SoloPenguin/Fytotron/Fytotron-Šimon-Hartmann 3.odt

Vyšší odborná škola a Střední průmyslová škola elektrotechnická Olomouc,

Božetěchova 3

PRAKTICKÁ ZKOUŠKA Z ODBORNÝCH PŘEDMĚTŮ

Fytotron
-

Vnitřní mini zahrádka pro pěstování bylinek

2018 Šimon Hartmann

Prohlašuji, že jsem praktickou zkoušku z odborných předmětů vypracoval samostatně a všechny prameny jsem uvedl v seznamu použité literatury.

……………………………

jméno a příjmení studenta

Chtěl bych vyslovit poděkování panu Marku Nožkovi za odborné konzultace a poskytnuté informace.

……………………………

jméno a příjmení studenta

Prohlašuji, že nemám námitek proti půjčování nebo zveřejňování mé práce nebo její části se souhlasem školy.

……………………………

jméno a příjmení studenta

1. Teoretický úvod
  1. – Fytotron

Fytotron(z řečtiny fyto - rostlina, tron- složité zařízení) v překladu "Klimatická komora" je zařízení k pěstování rostlin za kontrolovaných a programově regulovatelný vnějších podmínek ,zejména tedy teploty, vlhkosti a světla. Používá se ke studování působení vnějších vlivů na růst rostlin. Jedná se o produkt dvou vědeckých odvětví a to botaniky a fyziologie rostlin. **dopsat

První fytotron byl postaven pod vedením Fritsa Warmolta Wenta, nizozemského biologa, v Technologickém institutu v Kalifornii ( Caltech ) v roce 1949. F. W. Went ( 18. Května 1903 - 1. Května 1990 ) studoval na Univerzitě v Utrechtu. Jako disertační práci si vybral působení hormonu Auxin na rostliny a v roce 1928 demonstroval jeho přítomnost v rostlinách. Od roku 1927 do roku 1933 pracoval jako pracoval Went jako rostlinný patolog ve výzkumných laboratořích Královské botanické zahrady v Buitenzorg, Holandské východní Indie. Poté přijal místo na Caltech v Pasadeně v Kalifornii ,kde jako první studoval hormony v rostlinách. Sehrál důležitou roli při vývoji syntetických rostlinných hormonů, které se pak staly základem pro většinu zemědělského chemického průmyslu.

Fytotrony se v současnosti používají stále častěji. Novinkou je „Vertikální pěstování“. Místo pěstování rostlin na rozlehlých polích, které zabýrají mnoho místa, jsou rostliny pěstovány v policích, které se skládaji jedna na druhou. Tímto stylem je možné vypěstovat velké monžství rostlin na docela malém prostoru. Tato metoda se dá přirovnat ke stavění výškových domů. Díky stále více se rozmáhající technologii LED světel je výstavba takovýchto zařízení výrazně levnější, než tomu bylo v minulích letech. V minulosti se používaly sodíkové výbojky, které produkovaly celospektrální záření. Bylo to ovšem mnohlem více energeticky náročné, produkovaly velké množství tepla a výroba značně prodražovala celkovou cenu. Také se ukázalo, že používání světel , které produkují celé spektrum je zbytečné. Rostliny jsou totiž citlivé hlavně na červené a modré spektrum. A proto s nástupem LED bylo možné zaměřit se hlavně na spektum, které rostliny doopravdy potčebují. LED světla spotřebovávaji mnohem méně energie, neprodukují tolik tepla a jejich výroba v je porvonání s výbojkami, vcelku levná. Proto se v dnešní době používají stále víc a jejich upatnění stále roste. V současnosti existují dvě největší firmy, které využívají vertikální pěstování v kombinaci s LED osvětlením a to Growing Underground a AeroFarms. První, Growing Underground je anglická firma, která sídlí v Londíně ve starém bombovém kritu. Druhou je AeroFarms americká firma, sídlící v New Yorku. Ta používá velké skladištní budovy, ve kterých jsou rostliny naskládane v policích vysokých až 11m. Pečlivě také kontorlují a upravují vněší podmínky, výživu a osvětlení. Vertiklání pěstovaní je ovšem stále v dnešní době dražší než konvenční pěstování plodin na poli, levné sluneční světlo zatím stále vítězí nad umělými zdroji světla, ale s postupním nárůstém tohoto trendu je možné očekávát že za pár let by vertikální pěstování mohlo zcela osamostatnit větším města od dovozu čerstvích plodin z venkova. Douležitou věcí, kterou je třeba vspomenout je také fakt, že vertikální pěstování spotřebovává o 70% méně vody než klasické pěstování a se správnou technologií je možné tuto spořebu ještě zredukovat.

  2. – Arduino

V informatice jde o název pro malý jednodeskový počítač s mikrokontrolery ATmega od firmy Atmel. Je navrženo tak aby práce s ním byla jednoduchá a snaží se podpořit výuku informatiky na školách, tím že si na něm studenti mohou vyzkoušet, jak pomocí počítače řídit některá zařízení ( mrazák, mikrovlnná trouba, fytotron, atd. ). Arduino není navrženo jako běžný stolní počítač na rozdíl od Raspberry Pi, takže se k němu nedá jednoduše připojit klávesnice nebo monitor, ale je připraveno pro připojení LED diod, displeje z tekutých krystalu, senzorů nebo servomotorů.

Projekt Arduino vznikl v roce 2005 v Itálii ve městě Ivrea. Zakladateli byli Massimo Banzi a David Cuartielles, kteří svůj projekt pojmenovali podle Arduina Iverského, historicky významné postavy města.Cílem bylo vytvořit jednoduchou prototypovací platformu pro studenty, která umožní rychlý vývoj a jednoduché používání. Projekt zaznamenal velký úspěch. Začali vznikat nové verze a do únoru 2010 se prodalo více jak 120 tisíc kusů. Projekt Arduino získal ocenění v kategorii digitálních komunit na Prix Ars Electronica 2006.

Pro svoje potřeby jsem si vybral Arduino Mega2560, které ma 54 digitálních I/0 pinů, 16 analogových I/0 pinů a rozměry 101.6mm x 53.3mm. K Arduinu jsem připojil LCD Keypad Shield s 6 tlačítky, který zajistí vizualizaci některých výstupních dat. LCD Keypad Shield je vcelku rozměrný a na Arduinu Mega si zabral více jak polovinu pinů. Jako další jsem připojil RTC modul, který zajišťuje reálný čas, senzor teploty a vlhkosti DHT 11 a relé, které slouží k zapínání a vypínání LED pásků. Celý systém je napájený 12V DC zdrojem z počítače.

  3. – Programování

Pro programování Arduina je vyvinuto jednoduché programovací prostředí, ve kterém zvládnou naprogramovat jednoduché programy i úplní nováčci, Arduino IDE(integrated development enviroment = integrované vývojové prostředí) . Arduino je otevřená open-source,multiplatforma a na internetu lze jednoduše najít zdrojové kódy od uživatelů. Programy jsou psané v jazyce Writing, který navazuje na jazyk C.

Jazyk Writing má dvě hlavní funkce:

- Setup() - Funkce, která se zavolá při každém spuštěním nebo při stisknutí tlačítka Restart

- Slouží k nastavení pinů, proměnný, knihoven, atd.

- Loop() - Funkce, která se opakuje stále dokola

- Umožňuje tak reagovat na různé proměnlivé podněty

- Zapisuje se do něj většina logického kódu

Jak funkce Setup() tak funkce Loop() musí být zakončena složenými závorkami { }.

2. Návrh
  1. – Výpočty

Vztah člověka a rostliny ke světlu je už na samém počátku jejich existence výrazně odlišný. Pro člověka je světlo spíše psychologickým činitelem, kdy teplota světla, jeho intenzita, dynamika ovlivňují jeho bdělost, nálady a pracovní výkon . U rostlin je přítomnost světla a jeho kvalita mnohem zásadnější a má přímou souvislost s jejich fyzickým životem a kvalitním růstem. Zaměříme-li se na proces fotosyntézy (z řeckých slov fótos – světlo a synthesis – sjednocení, skládání), dospějeme k závěru, že světlo hraje v životě rostliny jednu ze zásadních podmínek.

6CO2 + 12H2O + světlo => C6H12O6 + 6O2 + 6H2O

Jelikož proces fotosyntézy probíhá ve dvou fázích je stejně jako dostatek světla důležitá i část temná. V první fázi, kdy na rostlinu dopadá světlo, dochází ke štěpení molekul vody

12H2O + světlo => 12H2 + 6O2

za vzniku vzdušného kyslíku a molekul vodíku, jenž je následně v temné fázi zužitkován na stavbu jednoduchého cukru, tedy glukózy, uložené ve vnitřní struktuře rostliny. Chemická rovnice fotosyntézy v temné fázi potom přejde do tvaru

6CO2 + 12H2 => C6H12O6 + 6H2O

Ke správnému vývoji potřebují rostliny nejen dostatek světla, ale hlavně to správné světelné spektrum. Při indoor pěstování se používají různé druhy výbojek a světelných zdrojů, které vyzařují odlišné množství světla, zasahující do několika částí světelného spektra. Světelné spektrum obsahuje tzv. spektrální barvy, které odpovídají různým intervalům (vzdálenostem) vlnových délek.

Lidské oko je schopné vnímat vlnové délky ve vzdálenosti cca od 400 do 800 nm (nanometrů), přičemž nejlépe vnímá v rozsahu 500-650 nm. Pro rostliny je důležité tzv. fotosynteticky aktivní záření (FAR), které se pohybuje v rozmezí 400-700 nm. Rostliny vnímají intenzivněji právě ve vlnových délkách, na které je lidské oko málo citlivé.

Fotosynteticky aktivní záření/radiace FAR (anglicky PAR – Photosynthetically Active Radiation) – světlo, které rostliny využívají k fotosyntéze. Zjednodušeně řečeno je to světlo, které rostliny vidí. Pohybuje se ve vlnových délkách 400-700 nm.

Ve svém projektu jsem použil tři druhy světelných zdrojů k osvětlení boxu o velikosti 0,25m x 0,35m x 0,35m. Velikost plochy, kterou osvětluji je 0,12 m².

Zdroje světla jsou žlutý, červený a modrý LED pásek. Žlutý pásek o délce 1m se světelným tokem 2100 lm, příkonem 20 W a tepelnou chromatičností 4000 – 4500 K. Červený pásek o délce 0,3m se světelným tokem 120 lm, příkonem 2W a vlnovou délkou 630 nm. Modrý pásek o délce 0,6m se světelným tokem 240 lm/m, příkonem 4W a vlnovou délkou 470 nm. Pásky jsou zapojeny sériově v třech samostatných obvodech, jejich proud je 1,6A , 0,33A a 0,17A a jejich celkový odběr je tedy 2,1A.

I = I1 + I2 + I3

Ovládání jednotlivých obvodů je zajištěno třemi relé, jež ovládá jednotka Arduino. Samo Arduino je napájeno ze stejného zdroje jako LED pásky, jeho odběr je ale zanedbatelný (0,04A), proto ho ve výpočtech nezahrnuji.

Červený LED pásek o vlnové délce 630 nm vytváří v boxu červené spektrum,které působí na chloprophyl a. Ten přispívá k tvorbě kořenového systému, dozrávání a růstu do výšky. Ve mém boxu tvoří pouze 1/6 z celkového osvětlení.

Morý LED pásek o vlnové délce 470 nm vytváří v boxu modré spektrum,které působí na chloprophyl b. Ten zajištuje tvorbu listů a cekové zelené masy. Modré LED pásky tovří 1/3 z celkového osvětlení.

Žlutý LED pásek s tepelnou chromatičností okolo 4000 – 4500 K a světelným tokem 2100 lm zastupuje v celkovém osvětlení ½ světel. Jeho role je, ale na rozdíl od červeného a modrého spektra, které zajišťují růst, spíše podpůrná. Zajišťuje střední vlnové délky, které rostliny rostliny vnímají méně, ale i přes to je důležitou součásti. Jeho hlávní úlohou je udržování teploty v boxu. Po odzkoušení jsem zjistli že dokáže udržet teplotu uvnitř boxu na idelánách 30 *C.

  2. - Schéma
  3. - Výkresy
3. Realizace
  1. -Sestavení

Seznam komponentů:

-LED pásky

-Hliníkové pásky (chladiče)

-Arduino Mega 2560

-Relé

-Box

-Reflexní fólie

-PC zdroj

-Reflexní folie

-Šroubky,matičky,vruty

-Vodiče

-Wago svorky

-Smrošťovací bužírka

Na začátku projektu bylo potřeba vybrat vhodný box ,ve kterém budu rostliny pěstovat. Rozhodnul jsem se pro plastový box o velikosti 0,25m x 0,37m x 0,37m. Plast se mi zdál jako ideální materiál, je velice lehký a nepodléhá téměř žádným vnějším vlivům. Na vnitřní strany boxu jsem pomocí oboustranné lepící pásky přichytil reflexní folii. Ta zajištje odraz světla a brání tomu, aby stěny boxu pohlcovaly světlo, které na ně dopadá.

S takto připraveným boxem už bylo možné vrhnout se na výrobu světelného zdroje. Jako první jsem potřeboval víko, na kterém budou připevněny LED pásky. Víko jsem vyrobil z dřevěné desky o tloušťce 1cm, kterou jsem upravil na požadované rozměry a to tak, aby víko lehce přesahovalo přes kraje boxu. Za pužití cirkulárky jsem vyrobil čtvercové víko o délce strany 0,4m. S takto vyrobeným víkem jsem mohl přejít k připevnění LED pásků. Z 2m hliníkové lišt, která slouží jako chladič pro LED pásky jsem nařezal 6 kratších lišt. Čtyři boční o délce 30 cm a dvě prostřední o délce 35 cm. Na obou stranách asi 5 cm od okraje jsem vrtačkou vyvrtal otvory pro vruty, kterými se lišty měli přichtit k víku. Otvory jsem zbrousil tak, aby hlavička vrutu nepřesahovala přes okraj a pásky tak mohly být přilepené k liště bez nerovností. Lišty jsem si na víku rozložil tak, aby vzdálenos mezi nimy byla stejná a to 6cm. Jestě před samotným přišroubováním jsem mezi lištu a víko vložil matku. Vznikl tak prostor mezi lištou a víkem, který napomáha lepšímu chlazení. Když byli lišty připevněné, mohl jsem konečně připevnit i LED pásky. Pásky jsem nastříhal v požadované délce a přilepil k hliníkovým lištám v poměru tři bíle LED pásky, dva modré a jeden červený. K páskmům bylo potřeba připájet vodiče, které jsem potom vytáhnul na druhou stranu víka. Spájel jsem dohromady plusové vodiče stejně barevných pásku a stejně tak i mínusové vodiče. Spoje jsem zaizoloval pomocí smrštovací bužírky. Dalším krokem bylo vytvořit si přívod k napájení. Ten sem vyrobyl z plastové destičky, kterou jsem v půlce natavil a zohnul, až vytvořila L. Na jedné straně jsem vyvrta dvě díry a do nich jsem zapustil dva vstupy pro banánky a druhou jsem vruty připevnil k výku. Vznikl mi tak přívod pro 12V. Pomocí wago svorek jsem spojil plusové vodiče s plusovým vstupem a mínusové vodiče s mínusovým vstupem a zapojení jsem otestoval. Jako zdroj jsem použil starý počítačový zdroj, který jsem velice jednoduše přetvořil v 12V DC zdroj. Pásky se rozsvítily bez zjevných problémů. Takto zapojené se ale nedali ovládat jednotlivé barvy. K tomu aby šli jednoduše ovládat potřeboval jsem relé, které by šlo programově ovládat. Jako ovládací jednotku jsem použil Arduino Mega2650. Arduino díky jeho jednoduché knostrukci a jednoduchému programovaní bylo pro tento projek ideální volbou. Arduino i relé spolu s několika dalšími moduly jsem objednal z internetového obchodu Amazon. Relé které jsem objednal bylo napájené 5V a dokázalo spínat až 10A. Použil jsem jedno relé pro každou jednotlivou barvu. Napajení pro tyto relé bylo možné přivést z Arduina, ale jelikož jsem měl v plánu na Arduinu připevnit LCD Keypad Shield, který nakonec zabíral víc jak polovinu pinů, rozhodl jsem se, že pomocí stabilizátoru na 5V budu relé napájet z 12V vstupu. Z dvou keramických kondenzátorů 22pF , jednoho kondenzátoru 68 µF a stablizátoru 7805 jsem vyrobil potřebnou součástku. Stabilizátor jsem přišrouboval k hliníkové destičcek, která odvádí teplo a slouží jako chladič. Poté už jen stačilo zapojit plusové vodiče od LED pásků do relé a přivést napájení ze stablilizátoru a zdroje . Relé spolu s Arduinem jsem připevnil k víku několika vruty a spojil datový vástupy relé s piny na Arduinu. Celé zapojení jsem nakonec otestoval, nahrál jsem do Arduina testovací program ,který spínal jednotlivé relé. Zapojení fungovalu, vše se zdálo v pořádku a já mohl přejít k programovoání.

  2. – Výsledky
  3. - Návrh na vylepšení
4. Závěr
