SoloPenguin/Fytotron/(list of files, cad)

Other CAD files:
fyto-bokorys.dwg
