SoloPenguin/Fytotron/(commit log)

2018-03-27 Fytotron-arduino 1
2018-03-27 arduino pridni časovače
